AleksandrBulygin/matrix_mul_module/activecore-master/designs/rtl/sigma/syn/syn_1stage/NEXYS4_DDR/NEXYS4_DDR.runs/impl_1/.init_design.begin.rst

<?xml version="1.0"?>
<ProcessHandle Version="1" Minor="0">
    <Process Command=".planAhead." Owner="admin" Host="DESKTOP-2FOCHV5" Pid="9392">
    </Process>
</ProcessHandle>
