AleksandrBulygin/matrix_mul_module/activecore-master/designs/rtl/sigma/syn/syn_3stage/NEXYS4_DDR/NEXYS4_DDR.runs/synth_1/.vivado.begin.rst

<?xml version="1.0"?>
<ProcessHandle Version="1" Minor="0">
    <Process Command="vivado.bat" Owner="admin" Host="DESKTOP-2FOCHV5" Pid="14744" HostCore="8" HostMemory="08474361856">
    </Process>
</ProcessHandle>
