AleksandrBulygin/matrix_mul_module/activecore-master/designs/rtl/sigma/syn/syn_4stage/NEXYS4_DDR/NEXYS4_DDR.runs/impl_1/tight_setup_hold_pins.txt

+--------------------------+--------------------------+----------------------------------------------------------------------------------------------------------+
|       Launch Clock       |      Capture Clock       |                                                 Pin                                                      |
+--------------------------+--------------------------+----------------------------------------------------------------------------------------------------------+
|         clk_out1_sys_clk |         clk_out1_sys_clk |                                                                  sigma/Mat_mul88/mul_reg_reg[0][17][25]/D|
|         clk_out1_sys_clk |         clk_out1_sys_clk |                                                                  sigma/Mat_mul88/mul_reg_reg[0][17][21]/D|
|         clk_out1_sys_clk |         clk_out1_sys_clk |                                                                  sigma/Mat_mul88/mul_reg_reg[1][13][30]/D|
|         clk_out1_sys_clk |         clk_out1_sys_clk |                                                                  sigma/Mat_mul88/mul_reg_reg[2][13][30]/D|
|         clk_out1_sys_clk |         clk_out1_sys_clk |                                                                  sigma/Mat_mul88/mul_reg_reg[2][14][27]/D|
|         clk_out1_sys_clk |         clk_out1_sys_clk |                                                                  sigma/Mat_mul88/mul_reg_reg[2][13][31]/D|
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
|         clk_out1_sys_clk |         clk_out1_sys_clk |                                                                  sigma/Mat_mul88/mul_reg_reg[1][13][12]/D|
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
