AleksandrBulygin/matrix_mul_module/activecore-master/designs/rtl/sigma/syn/syn_6stage/NEXYS4_DDR/NEXYS4_DDR.runs/impl_1/tight_setup_hold_pins.txt

+--------------------------+--------------------------+----------------------------------------------------------------------------------------------------------+
|       Launch Clock       |      Capture Clock       |                                                 Pin                                                      |
+--------------------------+--------------------------+----------------------------------------------------------------------------------------------------------+
|         clk_out1_sys_clk |         clk_out1_sys_clk |                        sigma/sigma_tile/riscv/gensticky_genpstage_EXEC_TRX_BUF_reg[0][alu_op2_wide][32]/D|
|         clk_out1_sys_clk |         clk_out1_sys_clk |                        sigma/sigma_tile/riscv/gensticky_genpstage_EXEC_TRX_BUF_reg[0][alu_op1_wide][32]/D|
|         clk_out1_sys_clk |         clk_out1_sys_clk |                        sigma/sigma_tile/riscv/gensticky_genpstage_EXEC_TRX_BUF_reg[0][alu_op1_wide][20]/D|
|         clk_out1_sys_clk |         clk_out1_sys_clk |                        sigma/sigma_tile/riscv/gensticky_genpstage_EXEC_TRX_BUF_reg[0][alu_op1_wide][31]/D|
|         clk_out1_sys_clk |         clk_out1_sys_clk |                        sigma/sigma_tile/riscv/gensticky_genpstage_EXEC_TRX_BUF_reg[0][alu_op1_wide][25]/D|
|         clk_out1_sys_clk |         clk_out1_sys_clk |                                             sigma/sigma_tile/riscv/gensticky_genpsticky_glbl_pc_reg[24]/D|
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
|         clk_out1_sys_clk |         clk_out1_sys_clk |                    sigma/sigma_tile/riscv/gensticky_genpstage_IDECODE_TRX_BUF_reg[0][curinstr_addr][21]/D|
|         clk_out1_sys_clk |         clk_out1_sys_clk |                    sigma/sigma_tile/riscv/gensticky_genpstage_IDECODE_TRX_BUF_reg[0][curinstr_addr][25]/D|
|         clk_out1_sys_clk |         clk_out1_sys_clk |                    sigma/sigma_tile/riscv/gensticky_genpstage_IDECODE_TRX_BUF_reg[0][nextinstr_addr][6]/D|
|         clk_out1_sys_clk |         clk_out1_sys_clk |                                              sigma/sigma_tile/riscv/gensticky_genpsticky_glbl_pc_reg[8]/D|
|         clk_out1_sys_clk |         clk_out1_sys_clk |                                              sigma/sigma_tile/riscv/gensticky_genpsticky_glbl_pc_reg[9]/D|
+--------------------------+--------------------------+----------------------------------------------------------------------------------------------------------+
