AleksandrBulygin/matrix_mul_module/activecore-master/designs/rtl/sigma/syn/syn_1stage/NEXYS4_DDR/NEXYS4_DDR.runs/impl_1/usage_statistics_webtalk.html

### Device Usage Page (usage_statistics_webtalk.html)

This HTML page displays the device usage statistics that will be sent to Xilinx.
To see the actual file transmitted to Xilinx, please click here.

software_version_and_target_device
beta | FALSE | build_version | 2552052
date_generated | Thu Nov 17 00:26:30 2022 | os_platform | WIN64
product_version | Vivado v2019.1 (64-bit) | project_id | 29e2278de4c149c8b6e064082325c144
project_iteration | 4 | random_id | f07bedc7bbdb52159f97cb6d6dda1e43
registration_id | f07bedc7bbdb52159f97cb6d6dda1e43 | route_design | TRUE
target_device | xc7a100t | target_family | artix7
target_package | csg324 | target_speed | -3
tool_flow | Vivado

user_environment
cpu_name | Intel(R) Core(TM) i7-6700HQ CPU @ 2.60GHz | cpu_speed | 2592 MHz
os_name | Windows Server 2016 or Windows 10 | os_release | major release (build 9200)
system_ram | 8.000 GB | total_processors | 1

vivado_usage

gui_handlers
abstractsearchablepanel_show_search=1 | addsrcwizard_specify_simulation_specific_hdl_files=2 | basedialog_cancel=1 | basedialog_ok=22
basedialog_yes=7 | cmdmsgdialog_ok=6 | createsrcfiledialog_file_name=1 | createsrcfiledialog_file_type=1
designtimingsumsectionpanel_worst_negative_slack=2 | expruntreepanel_exp_run_tree_table=2 | filesetpanel_file_set_panel_tree=100 | flownavigatortreepanel_flow_navigator_tree=36
hardwaretreepanel_hardware_tree_table=1 | hcodeeditor_close=1 | hcodeeditor_search_text_combo_box=2 | mainmenumgr_edit=6
mainmenumgr_file=6 | mainmenumgr_flow=3 | mainmenumgr_reports=4 | mainmenumgr_tools=3
mainmenumgr_view=2 | mainmenumgr_window=2 | mainwinmenumgr_layout=4 | msgview_clear_messages_resulting_from_user_executed=1
navigabletimingreporttab_timing_report_navigation_tree=12 | openfileaction_ok=1 | pacodeeditor_goto_definition=1 | pacommandnames_add_sources=3
pacommandnames_auto_connect_target=2 | pacommandnames_auto_update_hier=2 | pacommandnames_schematic=1 | pacommandnames_simulation_live_break=1
pacommandnames_simulation_live_run_all=61 | pacommandnames_simulation_relaunch=57 | pacommandnames_simulation_run_behavioral=10 | paviews_code=6
paviews_project_summary=14 | programfpgadialog_program=3 | programfpgadialog_specify_bitstream_file=5 | projectsummarytimingpanel_open_timing_summary_report=2
projecttab_reload=1 | rdicommands_properties=1 | rdicommands_waveform_save_configuration=2 | rdiviews_waveform_viewer=257
rungadget_show_error_and_critical_warning_messages=2 | saveprojectutils_save=3 | simpleoutputproductdialog_generate_output_products_immediately=3 | simulationobjectspanel_simulation_objects_tree_table=95
simulationscopespanel_simulate_scope_table=100 | srcchooserpanel_add_hdl_and_netlist_files_to_your_project=2 | srcchooserpanel_add_or_create_source_file=2 | srcchooserpanel_create_file=1
srcmenu_ip_hierarchy=2 | syntheticagettingstartedview_recent_projects=2 | syntheticastatemonitor_cancel=1 | taskbanner_close=5
tclconsoleview_tcl_console_code_editor=1 | timingitemflattablepanel_table=5 | waveformnametree_waveform_name_tree=190 | waveformview_goto_last_time=2
waveformview_goto_time_0=1 | waveformview_next_transition=512 | waveformview_previous_transition=336 | waveformview_swap_cursors=14

java_command_handlers
addsources=3 | autoconnecttarget=2 | editproperties=1 | launchprogramfpga=5
openexistingreport=1 | openhardwaremanager=7 | openrecenttarget=2 | programdevice=5
recustomizecore=5 | runbitgen=5 | runschematic=1 | showview=4
simulationbreak=1 | simulationrelaunch=56 | simulationrun=10 | simulationrunall=61
viewtaskimplementation=1 | viewtaskprojectmanager=5 | viewtasksimulation=3 | waveformrenameobject=1

waveformsaveconfiguration=2

other_data

guimode=4

project_data
constraintsetcount=1 | core_container=true | currentimplrun=impl_1 | currentsynthesisrun=synth_1
default_library=xil_defaultlib | designmode=RTL | export_simulation_activehdl=7 | export_simulation_ies=7
export_simulation_modelsim=7 | export_simulation_questa=7 | export_simulation_riviera=7 | export_simulation_vcs=7
export_simulation_xsim=7 | implstrategy=Vivado Implementation Defaults | launch_simulation_activehdl=0 | launch_simulation_ies=0
launch_simulation_modelsim=0 | launch_simulation_questa=0 | launch_simulation_riviera=0 | launch_simulation_vcs=0
launch_simulation_xsim=363 | simulator_language=Mixed | srcsetcount=33 | synthesisstrategy=Vivado Synthesis Defaults
target_language=Verilog | target_simulator=XSim | totalimplruns=2 | totalsynthesisruns=2

unisim_transformation

post_unisim_transformation
bufg=2 | carry4=870 | dsp48e1=196 | fdce=24928
fdpe=4 | fdre=2136 | fdse=4 | gnd=17
ibuf=20 | lut1=190 | lut2=2109 | lut3=553
lut4=1775 | lut5=616 | lut6=6764 | mmcme2_adv=1
muxf7=1475 | muxf8=192 | obuf=17 | ramb36e1=8

vcc=19

pre_unisim_transformation
bufg=2 | carry4=870 | dsp48e1=196 | fdce=24928
fdpe=4 | fdre=2136 | fdse=4 | gnd=17
ibuf=20 | lut1=190 | lut2=2109 | lut3=553
lut4=1775 | lut5=616 | lut6=6764 | mmcme2_adv=1
muxf7=1475 | muxf8=192 | obuf=17 | ramb36e1=8

vcc=19

power_opt_design

command_line_options_spo
-cell_types=default::all | -clocks=default::[not_specified] | -exclude_cells=default::[not_specified] | -include_cells=default::[not_specified]

usage
bram_ports_augmented=0 | bram_ports_newly_gated=0 | bram_ports_total=16 | flow_state=default
slice_registers_augmented=0 | slice_registers_newly_gated=0 | slice_registers_total=27089 | srls_augmented=0
srls_newly_gated=0 | srls_total=0

ip_statistics

clk_wiz_v6_0_3_0_0/1
clkin1_period=10.000 | clkin2_period=10.000 | clock_mgr_type=NA | component_name=sys_clk
core_container=NA | enable_axi=0 | feedback_source=FDBK_AUTO | feedback_type=SINGLE
iptotal=1 | manual_override=false | num_out_clk=1 | primitive=MMCM
use_dyn_phase_shift=false | use_dyn_reconfig=false | use_inclk_stopped=false | use_inclk_switchover=false
use_locked=true | use_max_i_jitter=false | use_min_o_jitter=false | use_phase_alignment=true
use_power_down=false | use_reset=true

report_drc

command_line_options
-append=default::[not_specified] | -checks=default::[not_specified] | -fail_on=default::[not_specified] | -force=default::[not_specified]
-format=default::[not_specified] | -internal=default::[not_specified] | -internal_only=default::[not_specified] | -messages=default::[not_specified]
-name=default::[not_specified] | -no_waivers=default::[not_specified] | -return_string=default::[not_specified] | -ruledecks=default::[not_specified]
-upgrade_cw=default::[not_specified] | -waived=default::[not_specified]

results
cfgbvs-1=1 | dpip-1=384 | dpop-1=196 | dpop-2=196

dpor-1=1024

report_methodology

command_line_options
-append=default::[not_specified] | -checks=default::[not_specified] | -fail_on=default::[not_specified] | -force=default::[not_specified]
-format=default::[not_specified] | -messages=default::[not_specified] | -name=default::[not_specified] | -return_string=default::[not_specified]
-slack_lesser_than=default::[not_specified] | -waived=default::[not_specified]

results
dpir-1=3200 | lutar-1=1 | synth-10=196 | synth-6=3

timing-6=2

report_power

command_line_options
-advisory=default::[not_specified] | -append=default::[not_specified] | -file=[specified] | -format=default::text
-hier=default::power | -hierarchical_depth=default::4 | -l=default::[not_specified] | -name=default::[not_specified]
-no_propagation=default::[not_specified] | -return_string=default::[not_specified] | -rpx=[specified] | -verbose=default::[not_specified]
-vid=default::[not_specified] | -xpe=default::[not_specified]

usage
airflow=250 (LFM) | ambient_temp=25.0 (C) | bi-dir_toggle=12.500000 | bidir_output_enable=1.000000
board_layers=12to15 (12 to 15 Layers) | board_selection=medium (10"x10") | bram=0.018142 | clocks=0.039435
confidence_level_clock_activity=High | confidence_level_design_state=High | confidence_level_device_models=High | confidence_level_internal_activity=Medium
confidence_level_io_activity=Low | confidence_level_overall=Low | customer=TBD | customer_class=TBD
devstatic=0.097788 | die=xc7a100tcsg324-3 | dsp=0.000085 | dsp_output_toggle=12.500000
dynamic=0.163108 | effective_thetaja=4.6 | enable_probability=0.990000 | family=artix7
ff_toggle=12.500000 | flow_state=routed | heatsink=medium (Medium Profile) | i/o=0.000124
input_toggle=12.500000 | junction_temp=26.2 (C) | logic=0.001712 | mgtavcc_dynamic_current=0.000000
mgtavcc_static_current=0.000000 | mgtavcc_total_current=0.000000 | mgtavcc_voltage=1.000000 | mgtavtt_dynamic_current=0.000000
mgtavtt_static_current=0.000000 | mgtavtt_total_current=0.000000 | mgtavtt_voltage=1.200000 | mmcm=0.121159
netlist_net_matched=NA | off-chip_power=0.000000 | on-chip_power=0.260896 | output_enable=1.000000
output_load=5.000000 | output_toggle=12.500000 | package=csg324 | pct_clock_constrained=33.000000
pct_inputs_defined=5 | platform=nt64 | process=typical | ram_enable=50.000000
ram_write=50.000000 | read_saif=False | set/reset_probability=0.000000 | signal_rate=False
signals=0.002168 | simulation_file=None | speedgrade=-3 | static_prob=False
temp_grade=extended | thetajb=5.7 (C/W) | thetasa=4.6 (C/W) | toggle_rate=False
user_board_temp=25.0 (C) | user_effective_thetaja=4.6 | user_junc_temp=26.2 (C) | user_thetajb=5.7 (C/W)
user_thetasa=4.6 (C/W) | vccadc_dynamic_current=0.000000 | vccadc_static_current=0.020000 | vccadc_total_current=0.020000
vccadc_voltage=1.800000 | vccaux_dynamic_current=0.067218 | vccaux_io_dynamic_current=0.000000 | vccaux_io_static_current=0.000000
vccaux_io_total_current=0.000000 | vccaux_io_voltage=1.800000 | vccaux_static_current=0.018175 | vccaux_total_current=0.085393
vccaux_voltage=1.800000 | vccbram_dynamic_current=0.001509 | vccbram_static_current=0.000358 | vccbram_total_current=0.001867
vccbram_voltage=1.000000 | vccint_dynamic_current=0.040587 | vccint_static_current=0.015515 | vccint_total_current=0.056102
vccint_voltage=1.000000 | vcco12_dynamic_current=0.000000 | vcco12_static_current=0.000000 | vcco12_total_current=0.000000
vcco12_voltage=1.200000 | vcco135_dynamic_current=0.000000 | vcco135_static_current=0.000000 | vcco135_total_current=0.000000
vcco135_voltage=1.350000 | vcco15_dynamic_current=0.000000 | vcco15_static_current=0.000000 | vcco15_total_current=0.000000
vcco15_voltage=1.500000 | vcco18_dynamic_current=0.000000 | vcco18_static_current=0.000000 | vcco18_total_current=0.000000
vcco18_voltage=1.800000 | vcco25_dynamic_current=0.000000 | vcco25_static_current=0.000000 | vcco25_total_current=0.000000
vcco25_voltage=2.500000 | vcco33_dynamic_current=0.000006 | vcco33_static_current=0.004000 | vcco33_total_current=0.004006
vcco33_voltage=3.300000 | version=2019.1

report_utilization

clocking
bufgctrl_available=32 | bufgctrl_fixed=0 | bufgctrl_used=3 | bufgctrl_util_percentage=9.38
bufhce_available=96 | bufhce_fixed=0 | bufhce_used=0 | bufhce_util_percentage=0.00
bufio_available=24 | bufio_fixed=0 | bufio_used=0 | bufio_util_percentage=0.00
bufmrce_available=12 | bufmrce_fixed=0 | bufmrce_used=0 | bufmrce_util_percentage=0.00
bufr_available=24 | bufr_fixed=0 | bufr_used=0 | bufr_util_percentage=0.00
mmcme2_adv_available=6 | mmcme2_adv_fixed=0 | mmcme2_adv_used=1 | mmcme2_adv_util_percentage=16.67
plle2_adv_available=6 | plle2_adv_fixed=0 | plle2_adv_used=0 | plle2_adv_util_percentage=0.00

dsp
dsp48e1_only_used=196 | dsps_available=240 | dsps_fixed=0 | dsps_used=196

dsps_util_percentage=81.67

io_standard
blvds_25=0 | diff_hstl_i=0 | diff_hstl_i_18=0 | diff_hstl_ii=0
diff_hstl_ii_18=0 | diff_hsul_12=0 | diff_mobile_ddr=0 | diff_sstl135=0
diff_sstl135_r=0 | diff_sstl15=0 | diff_sstl15_r=0 | diff_sstl18_i=0
diff_sstl18_ii=0 | hstl_i=0 | hstl_i_18=0 | hstl_ii=0
hstl_ii_18=0 | hsul_12=0 | lvcmos12=0 | lvcmos15=0
lvcmos18=0 | lvcmos25=0 | lvcmos33=1 | lvds_25=0
lvttl=0 | mini_lvds_25=0 | mobile_ddr=0 | pci33_3=0
ppds_25=0 | rsds_25=0 | sstl135=0 | sstl135_r=0
sstl15=0 | sstl15_r=0 | sstl18_i=0 | sstl18_ii=0

tmds_33=0

memory
block_ram_tile_available=135 | block_ram_tile_fixed=0 | block_ram_tile_used=8 | block_ram_tile_util_percentage=5.93
ramb18_available=270 | ramb18_fixed=0 | ramb18_used=0 | ramb18_util_percentage=0.00
ramb36_fifo_available=135 | ramb36_fifo_fixed=0 | ramb36_fifo_used=8 | ramb36_fifo_util_percentage=5.93

ramb36e1_only_used=8

primitives
bufg_functional_category=Clock | bufg_used=3 | carry4_functional_category=CarryLogic | carry4_used=870
dsp48e1_functional_category=Block Arithmetic | dsp48e1_used=196 | fdce_functional_category=Flop & Latch | fdce_used=24928
fdpe_functional_category=Flop & Latch | fdpe_used=4 | fdre_functional_category=Flop & Latch | fdre_used=2153
fdse_functional_category=Flop & Latch | fdse_used=4 | ibuf_functional_category=IO | ibuf_used=20
lut1_functional_category=LUT | lut1_used=98 | lut2_functional_category=LUT | lut2_used=2109
lut3_functional_category=LUT | lut3_used=553 | lut4_functional_category=LUT | lut4_used=1775
lut5_functional_category=LUT | lut5_used=616 | lut6_functional_category=LUT | lut6_used=6764
mmcme2_adv_functional_category=Clock | mmcme2_adv_used=1 | muxf7_functional_category=MuxFx | muxf7_used=1475
muxf8_functional_category=MuxFx | muxf8_used=192 | obuf_functional_category=IO | obuf_used=17
ramb36e1_functional_category=Block Memory | ramb36e1_used=8

slice_logic
f7_muxes_available=31700 | f7_muxes_fixed=0 | f7_muxes_used=1475 | f7_muxes_util_percentage=4.65
f8_muxes_available=15850 | f8_muxes_fixed=0 | f8_muxes_used=192 | f8_muxes_util_percentage=1.21
lut_as_logic_available=63400 | lut_as_logic_fixed=0 | lut_as_logic_used=11314 | lut_as_logic_util_percentage=17.85
lut_as_memory_available=19000 | lut_as_memory_fixed=0 | lut_as_memory_used=0 | lut_as_memory_util_percentage=0.00
register_as_flip_flop_available=126800 | register_as_flip_flop_fixed=0 | register_as_flip_flop_used=27089 | register_as_flip_flop_util_percentage=21.36
register_as_latch_available=126800 | register_as_latch_fixed=0 | register_as_latch_used=0 | register_as_latch_util_percentage=0.00
slice_luts_available=63400 | slice_luts_fixed=0 | slice_luts_used=11314 | slice_luts_util_percentage=17.85
slice_registers_available=126800 | slice_registers_fixed=0 | slice_registers_used=27089 | slice_registers_util_percentage=21.36
lut_as_distributed_ram_fixed=0 | lut_as_distributed_ram_used=0 | lut_as_logic_available=63400 | lut_as_logic_fixed=0
lut_as_logic_used=11314 | lut_as_logic_util_percentage=17.85 | lut_as_memory_available=19000 | lut_as_memory_fixed=0
lut_as_memory_used=0 | lut_as_memory_util_percentage=0.00 | lut_as_shift_register_fixed=0 | lut_as_shift_register_used=0
lut_in_front_of_the_register_is_unused_fixed=0 | lut_in_front_of_the_register_is_unused_used=18373 | lut_in_front_of_the_register_is_used_fixed=18373 | lut_in_front_of_the_register_is_used_used=4690
register_driven_from_outside_the_slice_fixed=4690 | register_driven_from_outside_the_slice_used=23063 | register_driven_from_within_the_slice_fixed=23063 | register_driven_from_within_the_slice_used=4026
slice_available=15850 | slice_fixed=0 | slice_registers_available=126800 | slice_registers_fixed=0
slice_registers_used=27089 | slice_registers_util_percentage=21.36 | slice_used=7943 | slice_util_percentage=50.11
slicel_fixed=0 | slicel_used=5452 | slicem_fixed=0 | slicem_used=2491
unique_control_sets_available=15850 | unique_control_sets_fixed=15850 | unique_control_sets_used=157 | unique_control_sets_util_percentage=0.99
using_o5_and_o6_fixed=0.99 | using_o5_and_o6_used=601 | using_o5_output_only_fixed=601 | using_o5_output_only_used=0
using_o6_output_only_fixed=0 | using_o6_output_only_used=10713

specific_feature
bscane2_available=4 | bscane2_fixed=0 | bscane2_used=0 | bscane2_util_percentage=0.00
capturee2_available=1 | capturee2_fixed=0 | capturee2_used=0 | capturee2_util_percentage=0.00
dna_port_available=1 | dna_port_fixed=0 | dna_port_used=0 | dna_port_util_percentage=0.00
efuse_usr_available=1 | efuse_usr_fixed=0 | efuse_usr_used=0 | efuse_usr_util_percentage=0.00
frame_ecce2_available=1 | frame_ecce2_fixed=0 | frame_ecce2_used=0 | frame_ecce2_util_percentage=0.00
icape2_available=2 | icape2_fixed=0 | icape2_used=0 | icape2_util_percentage=0.00
pcie_2_1_available=1 | pcie_2_1_fixed=0 | pcie_2_1_used=0 | pcie_2_1_util_percentage=0.00
startupe2_available=1 | startupe2_fixed=0 | startupe2_used=0 | startupe2_util_percentage=0.00
xadc_available=1 | xadc_fixed=0 | xadc_used=0 | xadc_util_percentage=0.00

synthesis

command_line_options
-assert=default::[not_specified] | -bufg=default::12 | -cascade_dsp=default::auto | -constrset=default::[not_specified]
-control_set_opt_threshold=default::auto | -directive=default::default | -fanout_limit=default::10000 | -flatten_hierarchy=default::rebuilt
-fsm_extraction=default::auto | -gated_clock_conversion=default::off | -generic=default::[not_specified] | -include_dirs=default::[not_specified]
-keep_equivalent_registers=default::[not_specified] | -max_bram=default::-1 | -max_bram_cascade_height=default::-1 | -max_dsp=default::-1
-max_uram=default::-1 | -max_uram_cascade_height=default::-1 | -mode=default::default | -name=default::[not_specified]
-no_lc=default::[not_specified] | -no_srlextract=default::[not_specified] | -no_timing_driven=default::[not_specified] | -part=xc7a100tcsg324-3
-resource_sharing=default::auto | -retiming=default::[not_specified] | -rtl=default::[not_specified] | -rtl_skip_constraints=default::[not_specified]
-rtl_skip_ip=default::[not_specified] | -seu_protect=default::none | -sfcu=default::[not_specified] | -shreg_min_size=default::3
-top=NEXYS4_DDR | -verilog_define=default::[not_specified]

usage
elapsed=00:06:19s | hls_ip=0 | memory_gain=1244.922MB | memory_peak=1566.008MB

xsim

command_line_options
-sim_mode=behavioral | -sim_type=default::
