AleksandrBulygin/matrix_mul_module/activecore-master/designs/rtl/sigma/syn/syn_5stage/NEXYS4_DDR/NEXYS4_DDR.sim/sim_1/behav/xsim/xsim.dir/riscv_tb_behav/webtalk/usage_statistics_ext_xsim.html

### XSIM Usage Report

software_version_and_target_device
beta | FALSE | build_version | 2552052
date_generated | Wed Jan 11 19:51:17 2023 | os_platform | WIN64
product_version | XSIM v2019.1 (64-bit) | project_id | db908482450846a6b240e55f3ac5423d
project_iteration | 2 | random_id | a0233fb0-89c3-4e73-bb6e-fecc33b79ae8
registration_id | a0233fb0-89c3-4e73-bb6e-fecc33b79ae8 | route_design | FALSE
target_device | not_applicable | target_family | not_applicable
target_package | not_applicable | target_speed | not_applicable
tool_flow | xsim_vivado

user_environment
cpu_name | Intel(R) Core(TM) i7-6700HQ CPU @ 2.60GHz | cpu_speed | 2592 MHz
os_name | Windows Server 2016 or Windows 10 | os_release | major release (build 9200)
system_ram | 8.000 GB | total_processors | 1

vivado_usage

xsim

command_line_options
command=xsim | runall=true

usage
iteration=0 | runtime=130636935 ps | simulation_memory=11788_KB | simulation_time=7.23_sec

trace_waveform=true
