AleksandrBulygin/matrix_mul_module/activecore-master/designs/rtl/sigma_tile/hw/sigma_tile.sv

/*
 * sigma_tile.sv
 *
 *  Created on: 27.12.2017
 *      Author: Alexander Antonov <antonov.alex.alex@gmail.com>
 *     License: See LICENSE file for details
 */


`include "sigma_tile.svh"

`include "riscv_1stage.svh"
`include "riscv_2stage.svh"
`include "riscv_3stage.svh"
`include "riscv_4stage.svh"
`include "riscv_5stage.svh"
`include "riscv_6stage.svh"

module sigma_tile
#(
    parameter corenum=0
    , mem_init_type="elf"
    , mem_init_data="data.elf"
    , mem_size=1024
    , CPU="none"
    , PATH_THROUGH="YES"
    , SW_RESET_DEFAULT=0
    , IRQ_NUM_POW=4
)
(
    input clk_i
    , input rst_i

    , input sw_reset_enb_i = 1'b0
    , input sw_reset_set_i = 1'b0
    , input sw_reset_autoclr_i = 1'b0
    , output logic core_reset_o

    , input [(2**IRQ_NUM_POW)-1:0] irq_debounced_bi
    
    , MemSplit32.Slave hif     // host interface
    , MemSplit32.Master xif    // expansion interface
    
//    , input sw0_i
//    , output logic [IRQ_NUM_POW-1:0] cpu_irq_code_o
//    , output logic cpu_irq_ack_o
);

    localparam XIF_BITSEL  = 31;
    localparam SFR_BITSEL  = 20;
    
    MemSplit32 cpu_instr();
    MemSplit32 cpu_data();

    logic [(2**IRQ_NUM_POW)-1:0] irq_en;
    logic irq_timer;
    logic sgi_req;
    logic [IRQ_NUM_POW-1:0] sgi_code;

    logic cpu_irq_req;
    logic [IRQ_NUM_POW-1:0] cpu_irq_code;
    logic cpu_irq_ack;
//    logic bus1_iqr;
    
//    assign cpu_irq_code_o = cpu_irq_code;
//    assign cpu_irq_ack_o = cpu_irq_ack;

    irq_adapter #(
        .IRQ_NUM_POW(IRQ_NUM_POW)
    ) irq_adapter (
        .clk_i(clk_i)
        , .rst_i(core_reset_o)
        , .irq_debounced_bi((irq_debounced_bi | (irq_timer << 1)) & irq_en)
        , .sgi_req_i(sgi_req)
        , .sgi_code_bi(sgi_code)
        , .irq_req_o(cpu_irq_req)
        , .irq_code_bo(cpu_irq_code)
        , .irq_ack_i(cpu_irq_ack)
    );

    //// coprocessor M ////
    logic coproc_M_send_req, coproc_M_send_ack;
    genpmodule_riscv_5stage_genmcopipe_coproc_M_if_genstruct_fifo_wdata coproc_M_send_data;

    logic coproc_M_recv_req, coproc_M_recv_ack;
    logic [31:0] coproc_M_recv_data;
    assign coproc_M_recv_ack = 1'b1;

    genexu_MUL_DIV genexu_MUL_DIV (
        .clk_i(clk_i)
        , .rst_i(core_reset_o)
        
        , .stream_req_bus_genfifo_req_i(coproc_M_send_req)
        , .stream_req_bus_genfifo_rdata_bi(coproc_M_send_data.wdata)
        , .stream_req_bus_genfifo_ack_o(coproc_M_send_ack)

        , .stream_resp_bus_genfifo_req_o(coproc_M_recv_req)
        , .stream_resp_bus_genfifo_wdata_bo(coproc_M_recv_data)
        , .stream_resp_bus_genfifo_ack_i(coproc_M_recv_ack)
    );
    /////////////////

    //// coprocessor custom-0 ////
    logic coproc_custom0_send_req, coproc_custom0_send_ack;
    genpmodule_riscv_5stage_genmcopipe_coproc_custom0_if_genstruct_fifo_wdata coproc_custom0_send_data;

    logic coproc_custom0_recv_req, coproc_custom0_recv_ack;
    logic [31:0] coproc_custom0_recv_data;
    assign coproc_custom0_recv_ack = 1'b1;

    coproc_custom0_wrapper coproc_custom0_wrapper (
        .clk_i(clk_i)
        , .rst_i(core_reset_o)
        
        , .stream_req_bus_genfifo_req_i(coproc_custom0_send_req)
        , .stream_req_bus_genfifo_rdata_bi(coproc_custom0_send_data.wdata)
        , .stream_req_bus_genfifo_ack_o(coproc_custom0_send_ack)

        , .stream_resp_bus_genfifo_req_o(coproc_custom0_recv_req)
        , .stream_resp_bus_genfifo_wdata_bo(coproc_custom0_recv_data)
        , .stream_resp_bus_genfifo_ack_i(coproc_custom0_recv_ack)
    );
    /////////////////
	
    // Processor core
    generate
        if (CPU == "riscv_1stage")
            
            begin
    
            genpmodule_riscv_1stage_genmcopipe_instr_mem_genstruct_fifo_wdata instr_mem_struct_bus;
            assign cpu_instr.we     = instr_mem_struct_bus.we;
            assign cpu_instr.addr   = instr_mem_struct_bus.wdata.addr;
            assign cpu_instr.be     = instr_mem_struct_bus.wdata.be;
            assign cpu_instr.wdata  = instr_mem_struct_bus.wdata.wdata;
    
            genpmodule_riscv_1stage_genmcopipe_data_mem_genstruct_fifo_wdata data_mem_struct_bus;
            assign cpu_data.we      = data_mem_struct_bus.we;
            assign cpu_data.addr    = data_mem_struct_bus.wdata.addr;
            assign cpu_data.be      = data_mem_struct_bus.wdata.be;
            assign cpu_data.wdata   = data_mem_struct_bus.wdata.wdata;
    
            riscv_1stage riscv (
                .clk_i(clk_i)
                , .rst_i(core_reset_o)
                
                // interrupt bus
                , .irq_fifo_genfifo_req_i(cpu_irq_req)
                , .irq_fifo_genfifo_rdata_bi({0, cpu_irq_code})
                , .irq_fifo_genfifo_ack_o(cpu_irq_ack)
                
                // instr req bus
                , .genmcopipe_instr_mem_req_genfifo_req_o(cpu_instr.req)
                , .genmcopipe_instr_mem_req_genfifo_wdata_bo(instr_mem_struct_bus)
                , .genmcopipe_instr_mem_req_genfifo_ack_i(cpu_instr.ack)

                // instr resp bus
                , .genmcopipe_instr_mem_resp_genfifo_req_i(cpu_instr.resp)
                , .genmcopipe_instr_mem_resp_genfifo_rdata_bi(cpu_instr.rdata)
                // , .genmcopipe_instr_mem_resp_genfifo_ack_o
    
                // data req bus
                , .genmcopipe_data_mem_req_genfifo_req_o(cpu_data.req)
                , .genmcopipe_data_mem_req_genfifo_wdata_bo(data_mem_struct_bus)
                , .genmcopipe_data_mem_req_genfifo_ack_i(cpu_data.ack)
    
                // data resp bus
                , .genmcopipe_data_mem_resp_genfifo_req_i(cpu_data.resp)
                , .genmcopipe_data_mem_resp_genfifo_rdata_bi(cpu_data.rdata)
                //, .genmcopipe_data_mem_resp_genfifo_ack_o

                // coproc M req bus
                , .genmcopipe_coproc_M_if_req_genfifo_req_o(coproc_M_send_req)
                , .genmcopipe_coproc_M_if_req_genfifo_wdata_bo(coproc_M_send_data)
                , .genmcopipe_coproc_M_if_req_genfifo_ack_i(coproc_M_send_ack)

                // coproc M resp bus
                , .genmcopipe_coproc_M_if_resp_genfifo_req_i(coproc_M_recv_req)
                , .genmcopipe_coproc_M_if_resp_genfifo_rdata_bi(coproc_M_recv_data)
                //, .genmcopipe_coproc_M_if_resp_genfifo_ack_o

                // coproc custom0 req bus
                , .genmcopipe_coproc_custom0_if_req_genfifo_req_o(coproc_custom0_send_req)
                , .genmcopipe_coproc_custom0_if_req_genfifo_wdata_bo(coproc_custom0_send_data)
                , .genmcopipe_coproc_custom0_if_req_genfifo_ack_i(coproc_custom0_send_ack)

                // coproc custom0 resp bus
                , .genmcopipe_coproc_custom0_if_resp_genfifo_req_i(coproc_custom0_recv_req)
                , .genmcopipe_coproc_custom0_if_resp_genfifo_rdata_bi(coproc_custom0_recv_data)
                //, .genmcopipe_coproc_custom0_if_resp_genfifo_ack_o
            );
    
            end
    
        else if (CPU == "riscv_2stage")
        
            begin
    
            genpmodule_riscv_2stage_genmcopipe_instr_mem_genstruct_fifo_wdata instr_mem_struct_bus;
            assign cpu_instr.we     = instr_mem_struct_bus.we;
            assign cpu_instr.addr   = instr_mem_struct_bus.wdata.addr;
            assign cpu_instr.be     = instr_mem_struct_bus.wdata.be;
            assign cpu_instr.wdata  = instr_mem_struct_bus.wdata.wdata;
    
            genpmodule_riscv_2stage_genmcopipe_data_mem_genstruct_fifo_wdata data_mem_struct_bus;
            assign cpu_data.we      = data_mem_struct_bus.we;
            assign cpu_data.addr    = data_mem_struct_bus.wdata.addr;
            assign cpu_data.be      = data_mem_struct_bus.wdata.be;
            assign cpu_data.wdata   = data_mem_struct_bus.wdata.wdata;
    
            riscv_2stage riscv (
                .clk_i(clk_i)
                , .rst_i(core_reset_o)
                
                // interrupt bus
                , .irq_fifo_genfifo_req_i(cpu_irq_req)
                , .irq_fifo_genfifo_rdata_bi({0, cpu_irq_code})
                , .irq_fifo_genfifo_ack_o(cpu_irq_ack)
                
                // instr req bus
                , .genmcopipe_instr_mem_req_genfifo_req_o(cpu_instr.req)
                , .genmcopipe_instr_mem_req_genfifo_wdata_bo(instr_mem_struct_bus)
                , .genmcopipe_instr_mem_req_genfifo_ack_i(cpu_instr.ack)

                // instr resp bus
                , .genmcopipe_instr_mem_resp_genfifo_req_i(cpu_instr.resp)
                , .genmcopipe_instr_mem_resp_genfifo_rdata_bi(cpu_instr.rdata)
                // , .genmcopipe_instr_mem_resp_genfifo_ack_o
    
                // data req bus
                , .genmcopipe_data_mem_req_genfifo_req_o(cpu_data.req)
                , .genmcopipe_data_mem_req_genfifo_wdata_bo(data_mem_struct_bus)
                , .genmcopipe_data_mem_req_genfifo_ack_i(cpu_data.ack)
    
                // data resp bus
                , .genmcopipe_data_mem_resp_genfifo_req_i(cpu_data.resp)
                , .genmcopipe_data_mem_resp_genfifo_rdata_bi(cpu_data.rdata)
                //, .genmcopipe_data_mem_resp_genfifo_ack_o

                // coproc M req bus
                , .genmcopipe_coproc_M_if_req_genfifo_req_o(coproc_M_send_req)
                , .genmcopipe_coproc_M_if_req_genfifo_wdata_bo(coproc_M_send_data)
                , .genmcopipe_coproc_M_if_req_genfifo_ack_i(coproc_M_send_ack)

                // coproc M resp bus
                , .genmcopipe_coproc_M_if_resp_genfifo_req_i(coproc_M_recv_req)
                , .genmcopipe_coproc_M_if_resp_genfifo_rdata_bi(coproc_M_recv_data)
                //, .genmcopipe_coproc_M_if_resp_genfifo_ack_o

                // coproc custom0 req bus
                , .genmcopipe_coproc_custom0_if_req_genfifo_req_o(coproc_custom0_send_req)
                , .genmcopipe_coproc_custom0_if_req_genfifo_wdata_bo(coproc_custom0_send_data)
                , .genmcopipe_coproc_custom0_if_req_genfifo_ack_i(coproc_custom0_send_ack)

                // coproc custom0 resp bus
                , .genmcopipe_coproc_custom0_if_resp_genfifo_req_i(coproc_custom0_recv_req)
                , .genmcopipe_coproc_custom0_if_resp_genfifo_rdata_bi(coproc_custom0_recv_data)
                //, .genmcopipe_coproc_custom0_if_resp_genfifo_ack_o
            );
    
            end
    
        else if (CPU == "riscv_3stage")
        
            begin
    
            genpmodule_riscv_3stage_genmcopipe_instr_mem_genstruct_fifo_wdata instr_mem_struct_bus;
            assign cpu_instr.we     = instr_mem_struct_bus.we;
            assign cpu_instr.addr   = instr_mem_struct_bus.wdata.addr;
            assign cpu_instr.be     = instr_mem_struct_bus.wdata.be;
            assign cpu_instr.wdata  = instr_mem_struct_bus.wdata.wdata;
    
            genpmodule_riscv_3stage_genmcopipe_data_mem_genstruct_fifo_wdata data_mem_struct_bus;
            assign cpu_data.we      = data_mem_struct_bus.we;
            assign cpu_data.addr    = data_mem_struct_bus.wdata.addr;
            assign cpu_data.be      = data_mem_struct_bus.wdata.be;
            assign cpu_data.wdata   = data_mem_struct_bus.wdata.wdata;
    
            riscv_3stage riscv (
                .clk_i(clk_i)
                , .rst_i(core_reset_o)
                
                // interrupt bus
                , .irq_fifo_genfifo_req_i(cpu_irq_req)
                , .irq_fifo_genfifo_rdata_bi({0, cpu_irq_code})
                , .irq_fifo_genfifo_ack_o(cpu_irq_ack)
                
                // instr req bus
                , .genmcopipe_instr_mem_req_genfifo_req_o(cpu_instr.req)
                , .genmcopipe_instr_mem_req_genfifo_wdata_bo(instr_mem_struct_bus)
                , .genmcopipe_instr_mem_req_genfifo_ack_i(cpu_instr.ack)

                // instr resp bus
                , .genmcopipe_instr_mem_resp_genfifo_req_i(cpu_instr.resp)
                , .genmcopipe_instr_mem_resp_genfifo_rdata_bi(cpu_instr.rdata)
                // , .genmcopipe_instr_mem_resp_genfifo_ack_o
    
                // data req bus
                , .genmcopipe_data_mem_req_genfifo_req_o(cpu_data.req)
                , .genmcopipe_data_mem_req_genfifo_wdata_bo(data_mem_struct_bus)
                , .genmcopipe_data_mem_req_genfifo_ack_i(cpu_data.ack)
    
                // data resp bus
                , .genmcopipe_data_mem_resp_genfifo_req_i(cpu_data.resp)
                , .genmcopipe_data_mem_resp_genfifo_rdata_bi(cpu_data.rdata)
                //, .genmcopipe_data_mem_resp_genfifo_ack_o

                // coproc M req bus
                , .genmcopipe_coproc_M_if_req_genfifo_req_o(coproc_M_send_req)
                , .genmcopipe_coproc_M_if_req_genfifo_wdata_bo(coproc_M_send_data)
                , .genmcopipe_coproc_M_if_req_genfifo_ack_i(coproc_M_send_ack)

                // coproc M resp bus
                , .genmcopipe_coproc_M_if_resp_genfifo_req_i(coproc_M_recv_req)
                , .genmcopipe_coproc_M_if_resp_genfifo_rdata_bi(coproc_M_recv_data)
                //, .genmcopipe_coproc_M_if_resp_genfifo_ack_o

                // coproc custom0 req bus
                , .genmcopipe_coproc_custom0_if_req_genfifo_req_o(coproc_custom0_send_req)
                , .genmcopipe_coproc_custom0_if_req_genfifo_wdata_bo(coproc_custom0_send_data)
                , .genmcopipe_coproc_custom0_if_req_genfifo_ack_i(coproc_custom0_send_ack)

                // coproc custom0 resp bus
                , .genmcopipe_coproc_custom0_if_resp_genfifo_req_i(coproc_custom0_recv_req)
                , .genmcopipe_coproc_custom0_if_resp_genfifo_rdata_bi(coproc_custom0_recv_data)
                //, .genmcopipe_coproc_custom0_if_resp_genfifo_ack_o
            );
    
            end
    
        else if (CPU == "riscv_4stage")
        
            begin
    
            genpmodule_riscv_4stage_genmcopipe_instr_mem_genstruct_fifo_wdata instr_mem_struct_bus;
            assign cpu_instr.we     = instr_mem_struct_bus.we;
            assign cpu_instr.addr   = instr_mem_struct_bus.wdata.addr;
            assign cpu_instr.be     = instr_mem_struct_bus.wdata.be;
            assign cpu_instr.wdata  = instr_mem_struct_bus.wdata.wdata;
    
            genpmodule_riscv_4stage_genmcopipe_data_mem_genstruct_fifo_wdata data_mem_struct_bus;
            assign cpu_data.we      = data_mem_struct_bus.we;
            assign cpu_data.addr    = data_mem_struct_bus.wdata.addr;
            assign cpu_data.be      = data_mem_struct_bus.wdata.be;
            assign cpu_data.wdata   = data_mem_struct_bus.wdata.wdata;
    
            riscv_4stage riscv (
                .clk_i(clk_i)
                , .rst_i(core_reset_o)
                
                // interrupt bus
                , .irq_fifo_genfifo_req_i(cpu_irq_req)
                , .irq_fifo_genfifo_rdata_bi({0, cpu_irq_code})
                , .irq_fifo_genfifo_ack_o(cpu_irq_ack)
                
                // instr req bus
                , .genmcopipe_instr_mem_req_genfifo_req_o(cpu_instr.req)
                , .genmcopipe_instr_mem_req_genfifo_wdata_bo(instr_mem_struct_bus)
                , .genmcopipe_instr_mem_req_genfifo_ack_i(cpu_instr.ack)

                // instr resp bus
                , .genmcopipe_instr_mem_resp_genfifo_req_i(cpu_instr.resp)
                , .genmcopipe_instr_mem_resp_genfifo_rdata_bi(cpu_instr.rdata)
                // , .genmcopipe_instr_mem_resp_genfifo_ack_o
    
                // data req bus
                , .genmcopipe_data_mem_req_genfifo_req_o(cpu_data.req)
                , .genmcopipe_data_mem_req_genfifo_wdata_bo(data_mem_struct_bus)
                , .genmcopipe_data_mem_req_genfifo_ack_i(cpu_data.ack)
    
                // data resp bus
                , .genmcopipe_data_mem_resp_genfifo_req_i(cpu_data.resp)
                , .genmcopipe_data_mem_resp_genfifo_rdata_bi(cpu_data.rdata)
                //, .genmcopipe_data_mem_resp_genfifo_ack_o

                // coproc M req bus
                , .genmcopipe_coproc_M_if_req_genfifo_req_o(coproc_M_send_req)
                , .genmcopipe_coproc_M_if_req_genfifo_wdata_bo(coproc_M_send_data)
                , .genmcopipe_coproc_M_if_req_genfifo_ack_i(coproc_M_send_ack)

                // coproc M resp bus
                , .genmcopipe_coproc_M_if_resp_genfifo_req_i(coproc_M_recv_req)
                , .genmcopipe_coproc_M_if_resp_genfifo_rdata_bi(coproc_M_recv_data)
                //, .genmcopipe_coproc_M_if_resp_genfifo_ack_o

                // coproc custom0 req bus
                , .genmcopipe_coproc_custom0_if_req_genfifo_req_o(coproc_custom0_send_req)
                , .genmcopipe_coproc_custom0_if_req_genfifo_wdata_bo(coproc_custom0_send_data)
                , .genmcopipe_coproc_custom0_if_req_genfifo_ack_i(coproc_custom0_send_ack)

                // coproc custom0 resp bus
                , .genmcopipe_coproc_custom0_if_resp_genfifo_req_i(coproc_custom0_recv_req)
                , .genmcopipe_coproc_custom0_if_resp_genfifo_rdata_bi(coproc_custom0_recv_data)
                //, .genmcopipe_coproc_custom0_if_resp_genfifo_ack_o
            );
    
            end
    
        else if (CPU == "riscv_5stage")
        
            begin
    
            genpmodule_riscv_5stage_genmcopipe_instr_mem_genstruct_fifo_wdata instr_mem_struct_bus;
            assign cpu_instr.we     = instr_mem_struct_bus.we;
            assign cpu_instr.addr   = instr_mem_struct_bus.wdata.addr;
            assign cpu_instr.be     = instr_mem_struct_bus.wdata.be;
            assign cpu_instr.wdata  = instr_mem_struct_bus.wdata.wdata;
    
            genpmodule_riscv_5stage_genmcopipe_data_mem_genstruct_fifo_wdata data_mem_struct_bus;
            assign cpu_data.we      = data_mem_struct_bus.we;
            assign cpu_data.addr    = data_mem_struct_bus.wdata.addr;
            assign cpu_data.be      = data_mem_struct_bus.wdata.be;
            assign cpu_data.wdata   = data_mem_struct_bus.wdata.wdata;
    
            riscv_5stage riscv (
                .clk_i(clk_i)
                , .rst_i(core_reset_o)
                
                // interrupt bus
                , .irq_fifo_genfifo_req_i(cpu_irq_req)
                , .irq_fifo_genfifo_rdata_bi({0, cpu_irq_code})
                , .irq_fifo_genfifo_ack_o(cpu_irq_ack)
                
                // instr req bus
                , .genmcopipe_instr_mem_req_genfifo_req_o(cpu_instr.req)
                , .genmcopipe_instr_mem_req_genfifo_wdata_bo(instr_mem_struct_bus)
                , .genmcopipe_instr_mem_req_genfifo_ack_i(cpu_instr.ack)

                // instr resp bus
                , .genmcopipe_instr_mem_resp_genfifo_req_i(cpu_instr.resp)
                , .genmcopipe_instr_mem_resp_genfifo_rdata_bi(cpu_instr.rdata)
                // , .genmcopipe_instr_mem_resp_genfifo_ack_o
    
                // data req bus
                , .genmcopipe_data_mem_req_genfifo_req_o(cpu_data.req)
                , .genmcopipe_data_mem_req_genfifo_wdata_bo(data_mem_struct_bus)
                , .genmcopipe_data_mem_req_genfifo_ack_i(cpu_data.ack)

                // data resp bus
                , .genmcopipe_data_mem_resp_genfifo_req_i(cpu_data.resp)
                , .genmcopipe_data_mem_resp_genfifo_rdata_bi(cpu_data.rdata)
                //, .genmcopipe_data_mem_resp_genfifo_ack_o

                // coproc M req bus
                , .genmcopipe_coproc_M_if_req_genfifo_req_o(coproc_M_send_req)
                , .genmcopipe_coproc_M_if_req_genfifo_wdata_bo(coproc_M_send_data)
                , .genmcopipe_coproc_M_if_req_genfifo_ack_i(coproc_M_send_ack)

                // coproc M resp bus
                , .genmcopipe_coproc_M_if_resp_genfifo_req_i(coproc_M_recv_req)
                , .genmcopipe_coproc_M_if_resp_genfifo_rdata_bi(coproc_M_recv_data)
                //, .genmcopipe_coproc_M_if_resp_genfifo_ack_o

                // coproc custom0 req bus
                , .genmcopipe_coproc_custom0_if_req_genfifo_req_o(coproc_custom0_send_req)
                , .genmcopipe_coproc_custom0_if_req_genfifo_wdata_bo(coproc_custom0_send_data)
                , .genmcopipe_coproc_custom0_if_req_genfifo_ack_i(coproc_custom0_send_ack)

                // coproc custom0 resp bus
                , .genmcopipe_coproc_custom0_if_resp_genfifo_req_i(coproc_custom0_recv_req)
                , .genmcopipe_coproc_custom0_if_resp_genfifo_rdata_bi(coproc_custom0_recv_data)
                //, .genmcopipe_coproc_custom0_if_resp_genfifo_ack_o
            );
    
            end
    
        else if (CPU == "riscv_6stage")
        
            begin
    
            genpmodule_riscv_6stage_genmcopipe_instr_mem_genstruct_fifo_wdata instr_mem_struct_bus;
            assign cpu_instr.we     = instr_mem_struct_bus.we;
            assign cpu_instr.addr   = instr_mem_struct_bus.wdata.addr;
            assign cpu_instr.be     = instr_mem_struct_bus.wdata.be;
            assign cpu_instr.wdata  = instr_mem_struct_bus.wdata.wdata;
    
            genpmodule_riscv_6stage_genmcopipe_data_mem_genstruct_fifo_wdata data_mem_struct_bus;
            assign cpu_data.we      = data_mem_struct_bus.we;
            assign cpu_data.addr    = data_mem_struct_bus.wdata.addr;
            assign cpu_data.be      = data_mem_struct_bus.wdata.be;
            assign cpu_data.wdata   = data_mem_struct_bus.wdata.wdata;
    
            riscv_6stage riscv (
                .clk_i(clk_i)
                , .rst_i(core_reset_o)
                
                // interrupt bus
                , .irq_fifo_genfifo_req_i(cpu_irq_req)
                , .irq_fifo_genfifo_rdata_bi({0, cpu_irq_code})
                , .irq_fifo_genfifo_ack_o(cpu_irq_ack)
                
                // instr req bus
                , .genmcopipe_instr_mem_req_genfifo_req_o(cpu_instr.req)
                , .genmcopipe_instr_mem_req_genfifo_wdata_bo(instr_mem_struct_bus)
                , .genmcopipe_instr_mem_req_genfifo_ack_i(cpu_instr.ack)

                // instr resp bus
                , .genmcopipe_instr_mem_resp_genfifo_req_i(cpu_instr.resp)
                , .genmcopipe_instr_mem_resp_genfifo_rdata_bi(cpu_instr.rdata)
                // , .genmcopipe_instr_mem_resp_genfifo_ack_o
    
                // data req bus
                , .genmcopipe_data_mem_req_genfifo_req_o(cpu_data.req)
                , .genmcopipe_data_mem_req_genfifo_wdata_bo(data_mem_struct_bus)
                , .genmcopipe_data_mem_req_genfifo_ack_i(cpu_data.ack)
    
                // data resp bus
                , .genmcopipe_data_mem_resp_genfifo_req_i(cpu_data.resp)
                , .genmcopipe_data_mem_resp_genfifo_rdata_bi(cpu_data.rdata)
                //, .genmcopipe_data_mem_resp_genfifo_ack_o

                // coproc M req bus
                , .genmcopipe_coproc_M_if_req_genfifo_req_o(coproc_M_send_req)
                , .genmcopipe_coproc_M_if_req_genfifo_wdata_bo(coproc_M_send_data)
                , .genmcopipe_coproc_M_if_req_genfifo_ack_i(coproc_M_send_ack)

                // coproc M resp bus
                , .genmcopipe_coproc_M_if_resp_genfifo_req_i(coproc_M_recv_req)
                , .genmcopipe_coproc_M_if_resp_genfifo_rdata_bi(coproc_M_recv_data)
                //, .genmcopipe_coproc_M_if_resp_genfifo_ack_o

                // coproc custom0 req bus
                , .genmcopipe_coproc_custom0_if_req_genfifo_req_o(coproc_custom0_send_req)
                , .genmcopipe_coproc_custom0_if_req_genfifo_wdata_bo(coproc_custom0_send_data)
                , .genmcopipe_coproc_custom0_if_req_genfifo_ack_i(coproc_custom0_send_ack)

                // coproc custom0 resp bus
                , .genmcopipe_coproc_custom0_if_resp_genfifo_req_i(coproc_custom0_recv_req)
                , .genmcopipe_coproc_custom0_if_resp_genfifo_rdata_bi(coproc_custom0_recv_data)
                //, .genmcopipe_coproc_custom0_if_resp_genfifo_ack_o
            );
    
            end
    
        else
    
            cpu_stub cpu_stub (
                .clk_i(clk_i)
                , .rst_i(core_reset_o)
                
                , .instr_mem(cpu_instr)
                , .data_mem(cpu_data)
            );
        
    endgenerate

    MemSplit32 dmem_if();
    MemSplit32 sfr_if();
    
    generate
        if (PATH_THROUGH == "YES")
            begin

            arb_2m3s
            #(
                .SFR_BITSEL(SFR_BITSEL)
                , .XIF_BITSEL(XIF_BITSEL)
            ) arb_cpu (
                .clk_i      (clk_i)
                , .rst_i    (rst_i)

                , .m0(hif)
                , .m1(cpu_data)
                , .s0(dmem_if)
                , .s1(sfr_if)
                , .s2(xif)
            );

            end

        else
            begin
    
            MemSplit32 internal_if();
            MemSplit32 cpu_internal();

            arb_1m2s
            #(
                .BITSEL(XIF_BITSEL)
            ) arb_cpu (
                .clk_i      (clk_i)
                , .rst_i    (rst_i)

                , .m(cpu_data)
                , .s0(cpu_internal)
                , .s1(xif)
            );

            arb_2m1s arb_internal
            (
                .clk_i      (clk_i)
                , .rst_i    (rst_i)
                
                , .m0(cpu_internal)
                , .m1(hif)
                , .s(internal_if)
            );

            arb_1m2s
            #(
                .BITSEL(SFR_BITSEL)
            ) arb_l2 (
                .clk_i      (clk_i)
                , .rst_i    (rst_i)
                
                , .m(internal_if)
                , .s0(dmem_if)
                , .s1(sfr_if)
            );
            
            end

    endgenerate
    
	
	ram_dual_memsplit #(
		.init_type    (mem_init_type)
		, .init_data  (mem_init_data)
		, .dat_width  (32)
		, .adr_width  (30)
		, .mem_size   (mem_size)
		, .P0_FRAC    ("NO")
		, .P1_FRAC    ("YES")
	) ram (
		.clk_i(clk_i)
		, .rst_i(rst_i)

		, .bus0_req_i	(cpu_instr.req)
		, .bus0_we_i	(cpu_instr.we)
		, .bus0_addr_bi	(cpu_instr.addr)
		, .bus0_be_bi	(cpu_instr.be)
		, .bus0_wdata_bi(cpu_instr.wdata)
		, .bus0_ack_o	(cpu_instr.ack)

		, .bus0_resp_o	(cpu_instr.resp)
		, .bus0_rdata_bo(cpu_instr.rdata)

		, .bus1_req_i	(dmem_if.req)
		, .bus1_we_i	(dmem_if.we)
		, .bus1_addr_bi	(dmem_if.addr)
		, .bus1_be_bi	(dmem_if.be)
		, .bus1_wdata_bi(dmem_if.wdata)
		, .bus1_ack_o	(dmem_if.ack)

		, .bus1_resp_o	(dmem_if.resp)
		, .bus1_rdata_bo(dmem_if.rdata)
//		, .sw0_i(sw0_i)
//		, .bus1_iqr(bus1_iqr)
	);
	
    sfr #(
        .corenum(corenum)
        , .SW_RESET_DEFAULT(SW_RESET_DEFAULT)
        , .IRQ_NUM_POW(IRQ_NUM_POW)
    ) sfr (
        .clk_i		(clk_i)
        , .rst_i	(rst_i)

        , .host(sfr_if)

        , .sw_reset_enb_i(sw_reset_enb_i)
        , .sw_reset_set_i(sw_reset_set_i)
        , .sw_reset_autoclr_i(sw_reset_autoclr_i)
        , .core_reset_o(core_reset_o)

        , .irq_en_bo(irq_en)
        , .irq_timer(irq_timer)

        , .sgi_req_o(sgi_req)
        , .sgi_code_bo(sgi_code)
    );
	

endmodule
